sequoia-hope/rgb_led_earrings/earring.kicad_pcb

## KiCad design earring.kicad_pcb (2025-07-21)

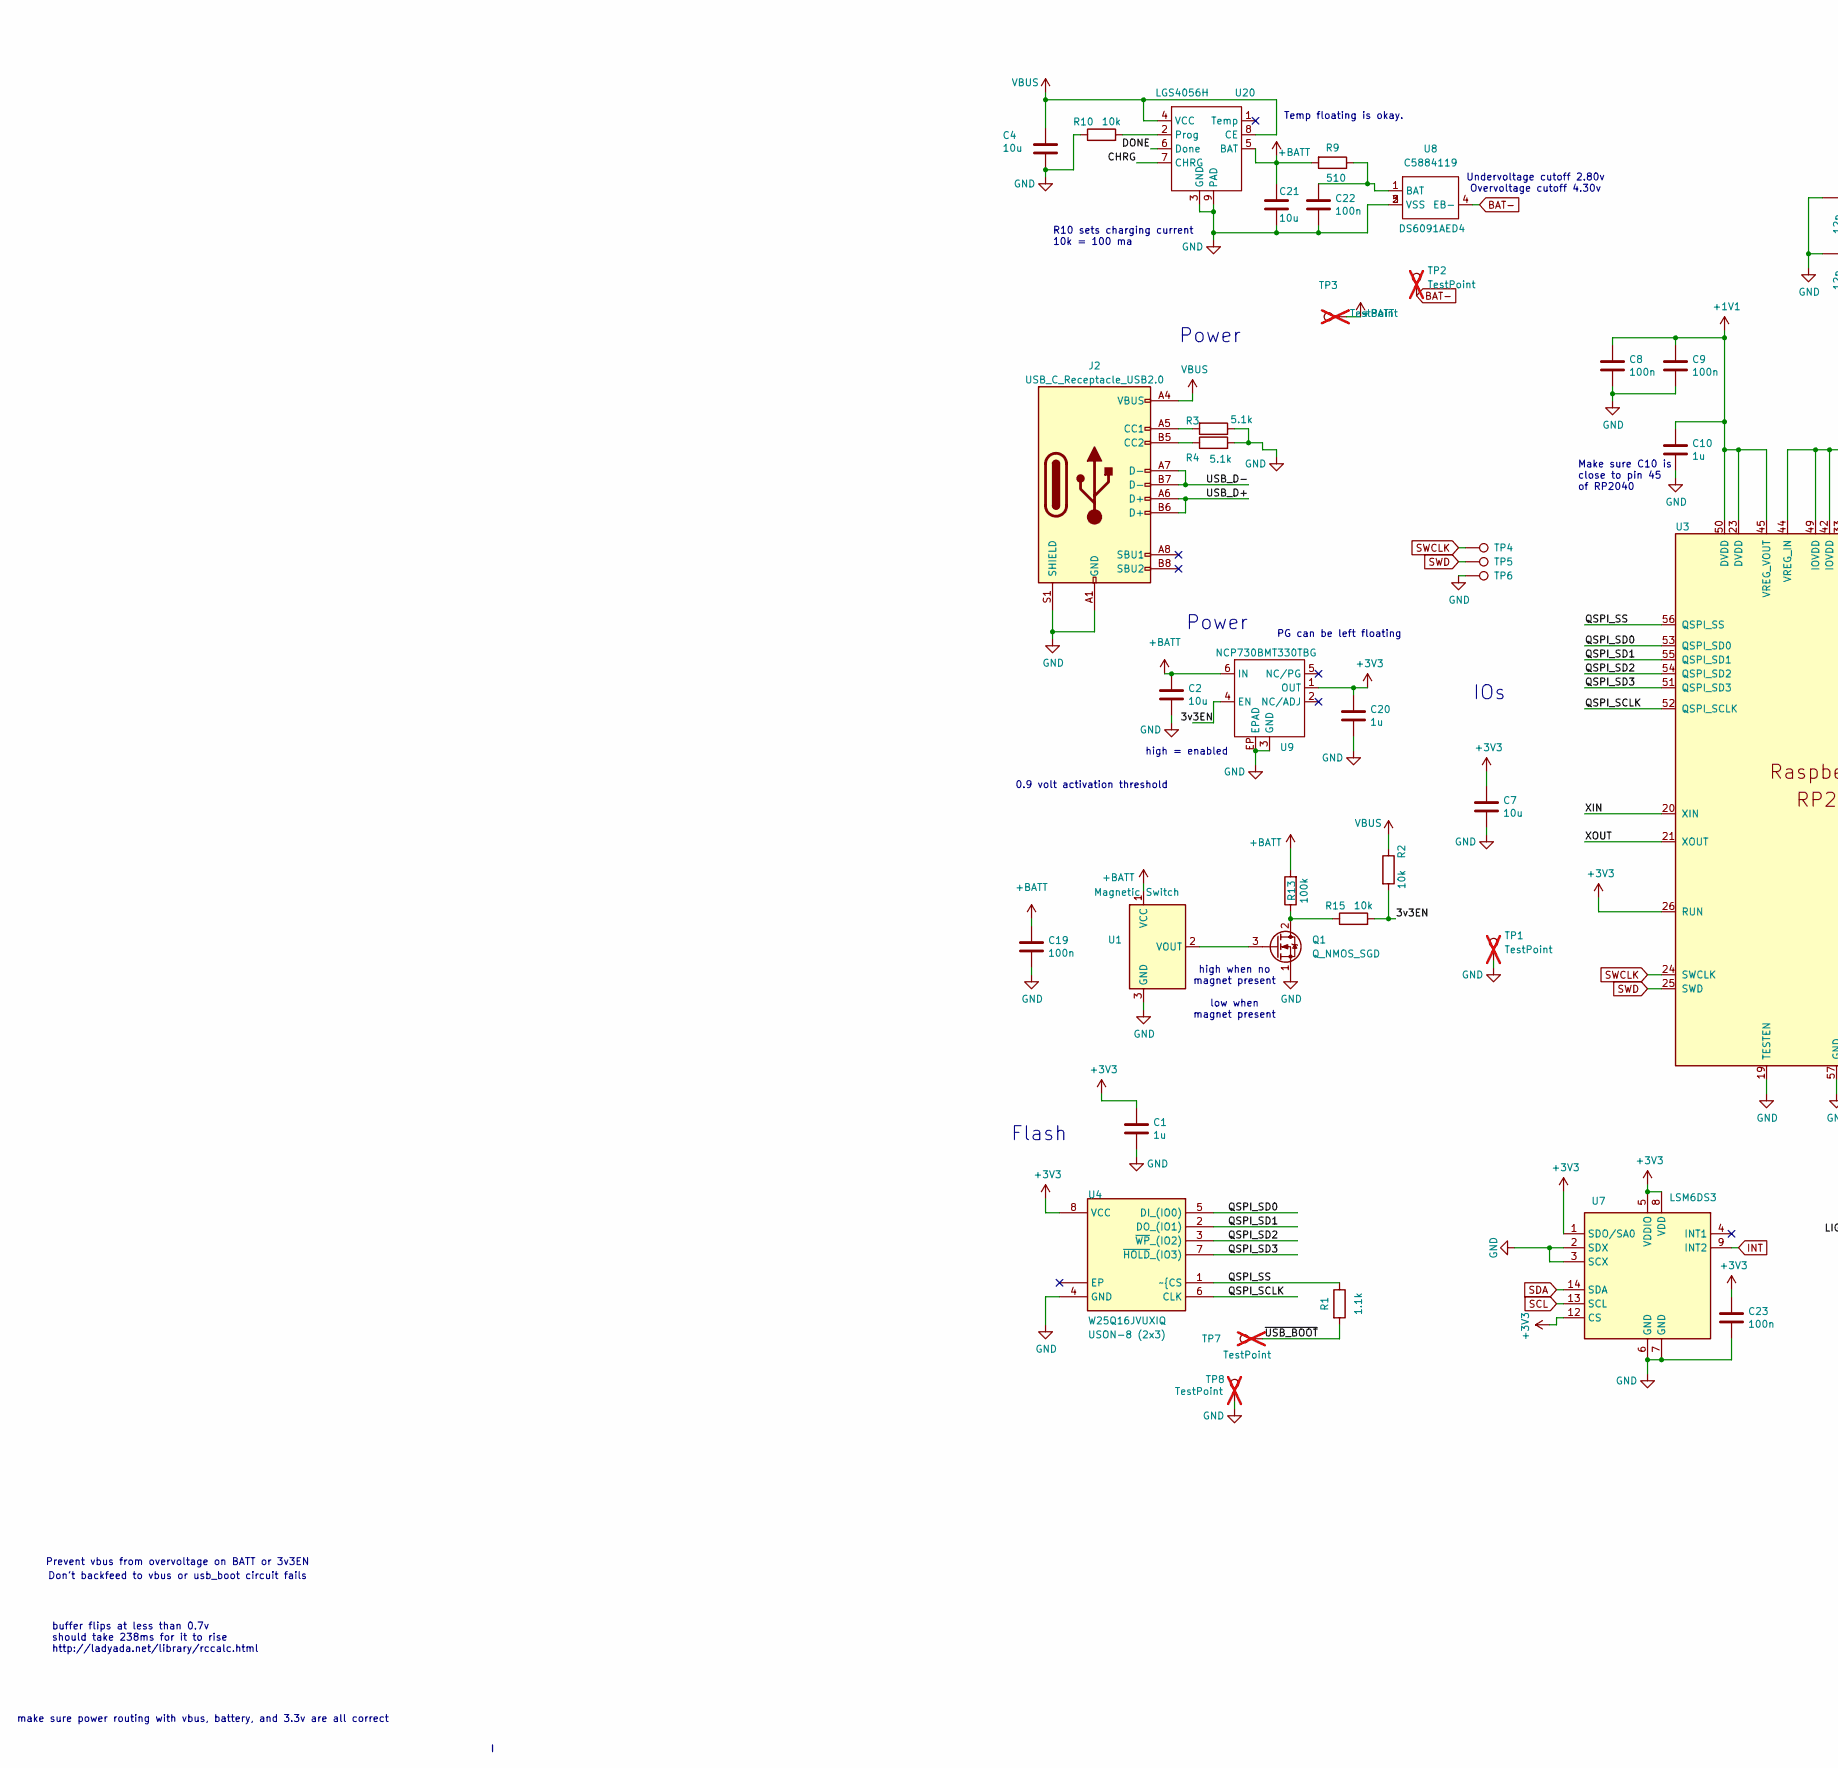
[picture p1: schematic earring.kicad_sch, RP2040 Earring, part in row 1, column 1]

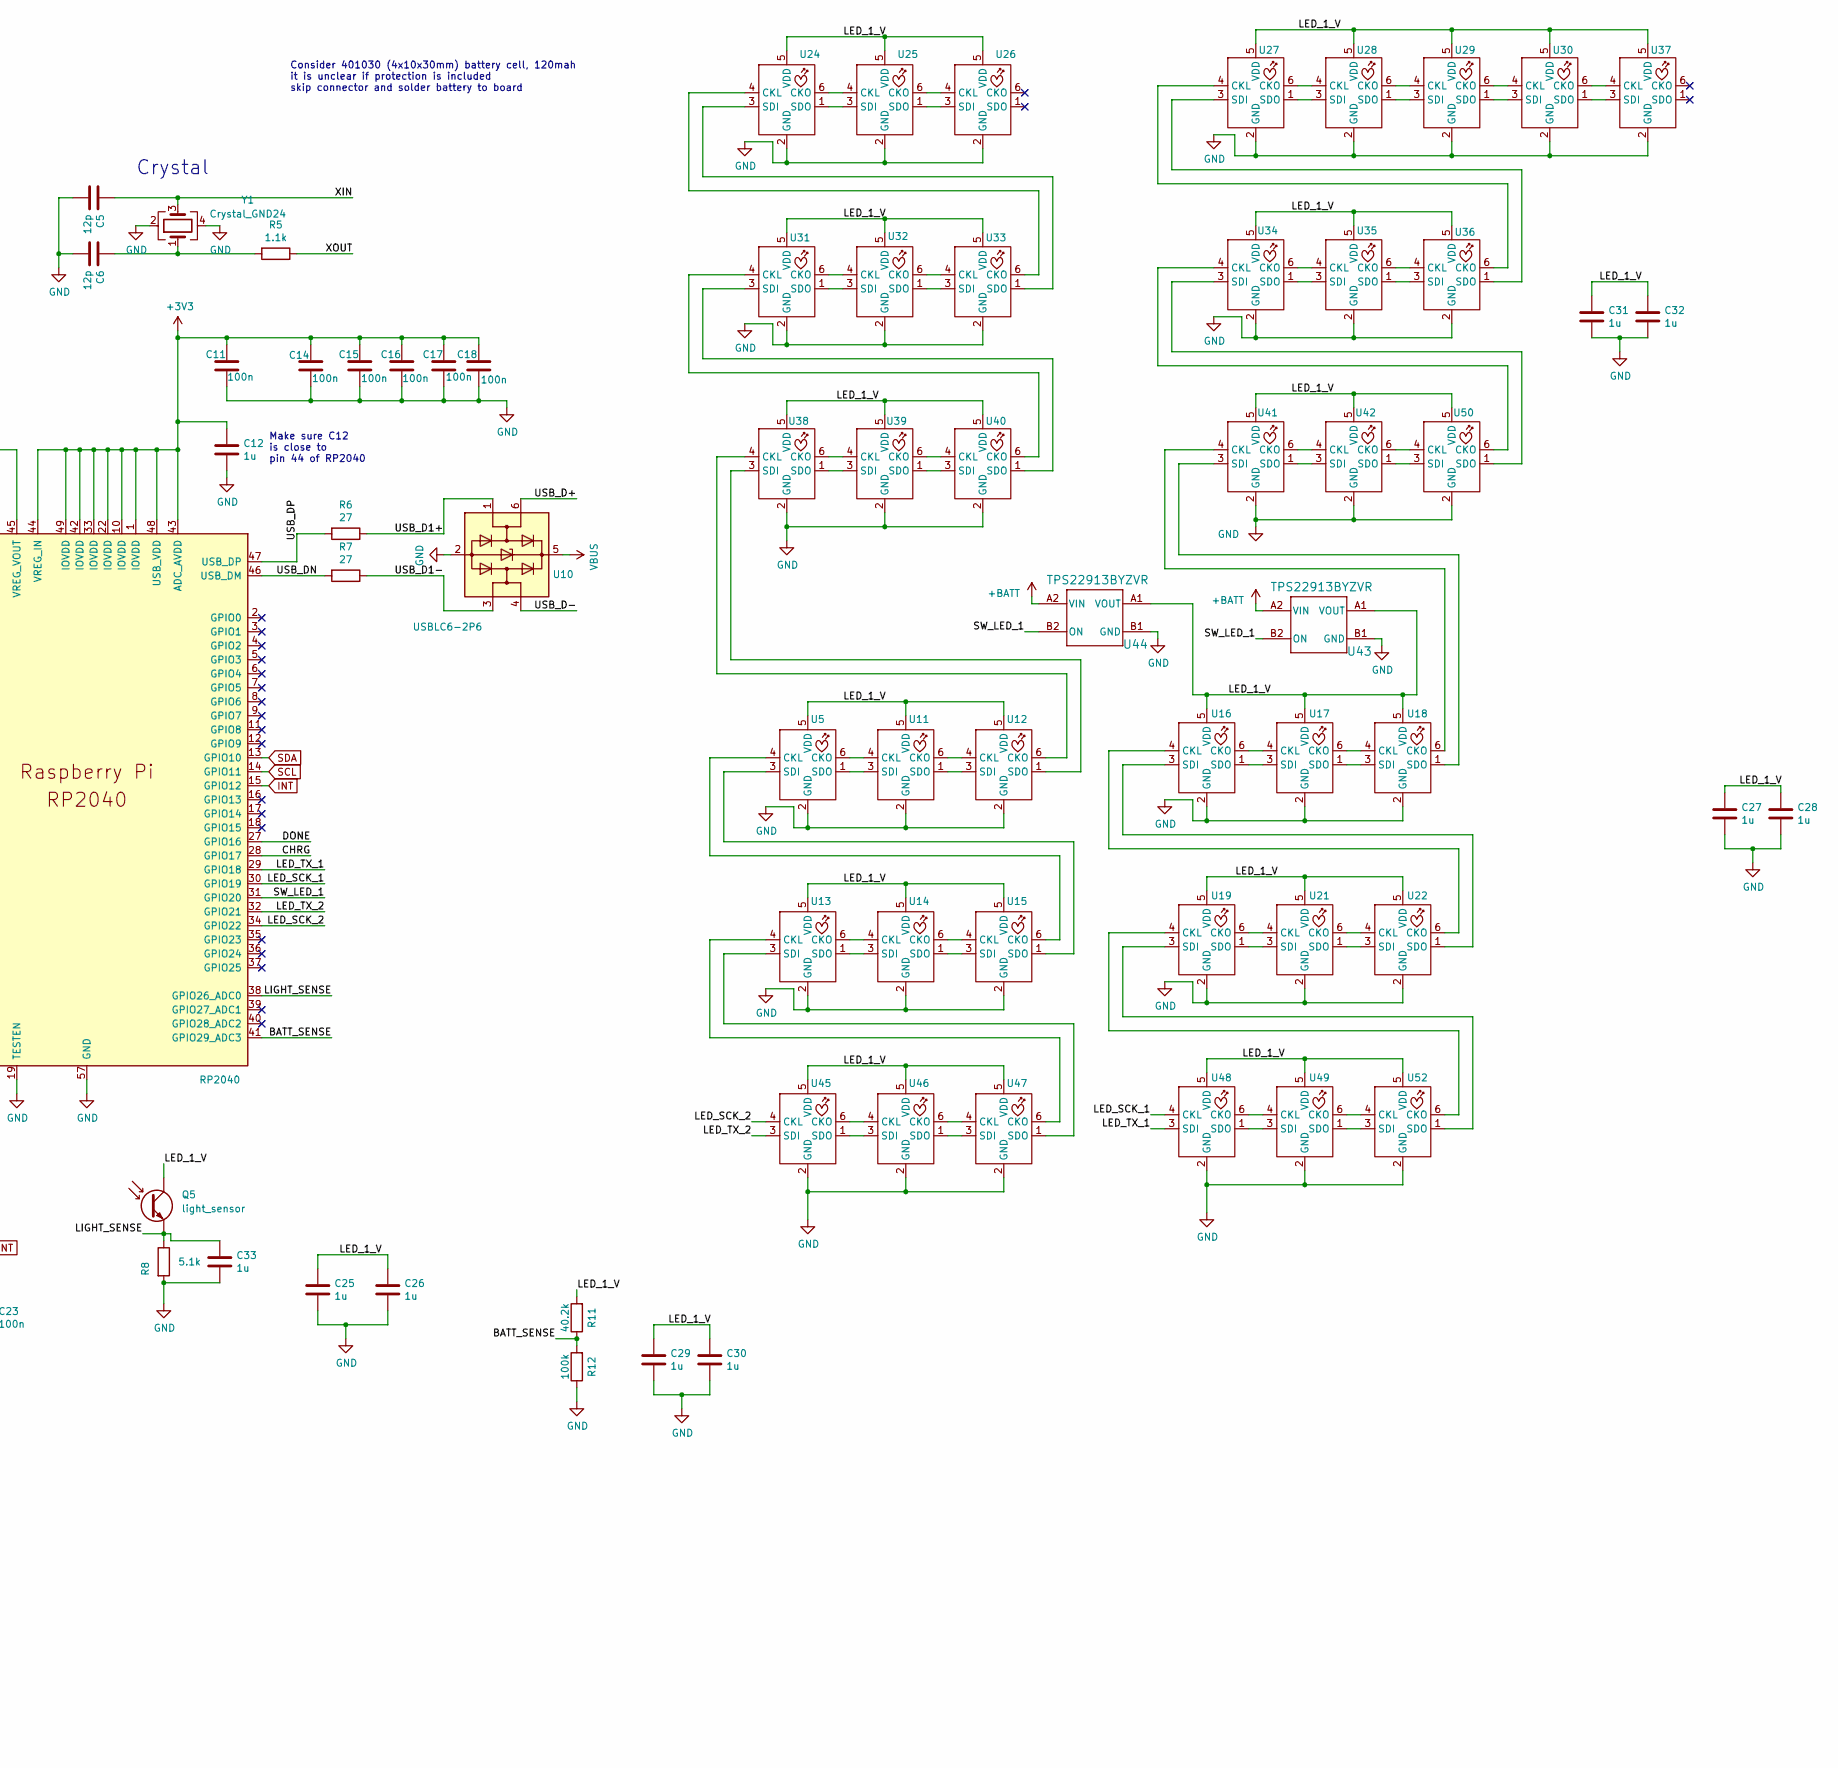
[picture p2: schematic earring.kicad_sch, RP2040 Earring, part in row 1, column 2]

Parts:
C1, C10, C12, C20, C25, C26, C27, C28, C29, C30, C31, C32, C33: 1u; C_0402_1005Metric; LCSC C29266
C2, C4, C7, C21: 10u; C_0402_1005Metric; LCSC C315248
C5, C6: 12p; C_0402_1005Metric; LCSC C1547
C8, C9, C11, C14, C15, C16, C17, C18, C19, C22, C23: 100n; C_0402_1005Metric; LCSC C60474
J2: USB_C_Receptacle_USB2.0; USB-C-TH_GT-USB-7055; LCSC C2686963
Q1: Q_NMOS_SGD; DFN1006-3L_L1.0-W0.6-BL; LCSC C504101
Q5: light_sensor; LED_0603_1608Metric; LCSC C146233
R1, R5: 1.1k; R_0402_1005Metric; LCSC C325543
R2, R10, R15: 10k; R_0402_1005Metric; LCSC C60490
R3, R4, R8: 5.1k; R_0402_1005Metric; LCSC C25905
R6, R7: 27; R_0402_1005Metric; LCSC C138021
R9: 510; R_0402_1005Metric; LCSC C137860
R11: 40.2k; R_0402_1005Metric; LCSC C25893
R12, R13: 100k; R_0402_1005Metric; LCSC C60491
TP1, TP7, TP8: TestPoint; TestPoint_Pad_D1.0mm; LCSC C238130; not fitted
TP2, TP3: TestPoint; TestPoint_Pad_2.0x2.0mm; LCSC C238130; not fitted
TP4, TP5, TP6: TestPoint; TestPoint_Pad_1.0x1.0mm
U1: Magnetic Switch; DFN1608-3_L1.5-W0.8-P0.42-BL-EP; LCSC C879626
U3: RP2040; RP2040-QFN-56; LCSC C2040
U4: W25Q16JVUXIQ; IC_W25Q16JVUXIQ_TR; MPN W25Q16JVUXIQ; LCSC C2843335
U5, U11, U12, U13, U14, U15, U16, U17, U18, U19, U21, U22, U24, U25, U26, U27, U28, U29, U30, U31, U32, U33, U34, U35, U36, U37, U38, U39, U40, U41, U42, U45, U46, U47, U48, U49, U50, U52: LED-SK9822-EC20
U7: LSM6DS3; LGA-14_3x2.5mm_P0.5mm_LayoutBorder3x4y; LCSC C2829074
U8: DS6091AED4; DFN1x1; LCSC C5884119
U9: NCP730BMT330TBG; WDFN-6-2x2; LCSC C892821
U10: USBLC6-2P6; SOT-666; LCSC C2827693
U20: LGS4056H; DFN-8-1EP_2x2mm_P0.5mm_EP0.9x1.5mm; LCSC C5124109
U43, U44: TPS22913BYZVR; YZV0004ADAD; LCSC C544698
Y1: Crystal_GND24; Crystal_SMD_2520-4Pin_2.5x2.0mm; LCSC C284155

Connections:
+1V1: C8.1, C9.1, C10.1, U3.23 (DVDD), U3.45 (VREG_VOUT), U3.50 (DVDD)
+3V3: C1.1, C7.1, C11.1, C12.1, C14.1, C15.1, C16.1, C17.1, C18.1, C20.1, C23.1, U3.1 (IOVDD), U3.10 (IOVDD), U3.22 (IOVDD), U3.26 (RUN), U3.33 (IOVDD), U3.42 (IOVDD), U3.43 (ADC_AVDD), U3.44 (VREG_IN), U3.48 (USB_VDD), U3.49 (IOVDD), U4.8 (VCC), U7.1 (SDO/SA0), U7.5 (VDDIO), U7.8 (VDD), U7.12 (CS), U9.1 (OUT)
+BATT: C2.1, C19.1, C21.1, R9.2, R13.2, TP3.1, U1.1 (VCC), U9.6 (IN), U20.5 (BAT), U43.A2 (VIN), U44.A2 (VIN)
/3v3EN: R2.2, R15.2, U9.4 (EN)
/BATT_SENSE: R11.1, R12.2, U3.41 (GPIO29_ADC3)
/CHRG: U3.28 (GPIO17), U20.7 (CHRG)
/DONE: U3.27 (GPIO16), U20.6 (Done)
/LED_1_V: C25.1, C26.1, C27.1, C28.1, C29.1, C30.1, C31.1, C32.1, Q5.1, R11.2, U5.5 (VDD), U11.5 (VDD), U12.5 (VDD), U13.5 (VDD), U14.5 (VDD), U15.5 (VDD), U16.5 (VDD), U17.5 (VDD), U18.5 (VDD), U19.5 (VDD), U21.5 (VDD), U22.5 (VDD), U24.5 (VDD), U25.5 (VDD), U26.5 (VDD), U27.5 (VDD), U28.5 (VDD), U29.5 (VDD), U30.5 (VDD), U31.5 (VDD), U32.5 (VDD), U33.5 (VDD), U34.5 (VDD), U35.5 (VDD), U36.5 (VDD), U37.5 (VDD), U38.5 (VDD), U39.5 (VDD), U40.5 (VDD), U41.5 (VDD), U42.5 (VDD), U43.A1 (VOUT), U44.A1 (VOUT), U45.5 (VDD), U46.5 (VDD), U47.5 (VDD), U48.5 (VDD), U49.5 (VDD), U50.5 (VDD), U52.5 (VDD)
/LED_SCK_1: U3.30 (GPIO19), U48.4 (CKL)
/LED_SCK_2: U3.34 (GPIO22), U45.4 (CKL)
/LED_TX_1: U3.29 (GPIO18), U48.3 (SDI)
/LED_TX_2: U3.32 (GPIO21), U45.3 (SDI)
/LIGHT_SENSE: C33.1, Q5.2, R8.1, U3.38 (GPIO26_ADC0)
/QSPI_SCLK: U3.52 (QSPI_SCLK), U4.6 (CLK)
/QSPI_SD0: U3.53 (QSPI_SD0), U4.5 (DI_(IO0))
/QSPI_SD1: U3.55 (QSPI_SD1), U4.2 (DO_(IO1))
/QSPI_SD2: U3.54 (QSPI_SD2), U4.3 (~WP_(IO2))
/QSPI_SD3: U3.51 (QSPI_SD3), U4.7 (~HOLD_(IO3))
/QSPI_SS: R1.1, U3.56 (QSPI_SS), U4.1 (~{CS)
/SW_LED_1: U3.31 (GPIO20), U43.B2 (ON), U44.B2 (ON)
/USB_D1+: R6.1, U10.1 (I/O1)
/USB_D1-: R7.1, U10.3 (I/O2)
/USB_D+: J2.A6 (D+), J2.B6 (D+), U10.6 (I/O1)
/USB_D-: J2.A7 (D-), J2.B7 (D-), U10.4 (I/O2)
/USB_DN: R7.2, U3.46 (USB_DM)
/USB_DP: R6.2, U3.47 (USB_DP)
/XIN: C5.1, U3.20 (XIN), Y1.3
/XOUT: R5.1, U3.21 (XOUT)
/~USB_BOOT: R1.2, TP7.1
BAT-: TP2.1, U8.4 (EB-)
GND: C1.2, C2.2, C4.2, C5.2, C6.2, C7.2, C8.2, C9.2, C10.2, C11.2, C12.2, C14.2, C15.2, C16.2, C17.2, C18.2, C19.2, C20.2, C21.2, C22.2, C23.2, C25.2, C26.2, C27.2, C28.2, C29.2, C30.2, C31.2, C32.2, C33.2, J2.A1 (GND), J2.A12 (GND), J2.B1 (GND), J2.B12 (GND), J2.S1 (SHIELD), Q1.1 (S), R3.1, R4.2, R8.2, R10.1, R12.1, TP1.1, TP6.1, TP8.1, U1.3 (GND), U3.19 (TESTEN), U3.57 (GND), U4.4 (GND), U5.2 (GND), U7.2 (SDX), U7.3 (SCX), U7.6 (GND), U7.7 (GND), U8.2 (VSS), U8.3 (VSS), U8.5 (VSS), U9.3 (GND), U9.EP (EPAD), U10.2 (GND), U11.2 (GND), U12.2 (GND), U13.2 (GND), U14.2 (GND), U15.2 (GND), U16.2 (GND), U17.2 (GND), U18.2 (GND), U19.2 (GND), U20.3 (GND), U20.9 (PAD), U21.2 (GND), U22.2 (GND), U24.2 (GND), U25.2 (GND), U26.2 (GND), U27.2 (GND), U28.2 (GND), U29.2 (GND), U30.2 (GND), U31.2 (GND), U32.2 (GND), U33.2 (GND), U34.2 (GND), U35.2 (GND), U36.2 (GND), U37.2 (GND), U38.2 (GND), U39.2 (GND), U40.2 (GND), U41.2 (GND), U42.2 (GND), U43.B1 (GND), U44.B1 (GND), U45.2 (GND), U46.2 (GND), U47.2 (GND), U48.2 (GND), U49.2 (GND), U50.2 (GND), U52.2 (GND), Y1.2, Y1.4
INT: U3.15 (GPIO12), U7.9 (INT2)
unnamed: C6.1, R5.2, Y1.1
unnamed: J2.A5 (CC1), R3.2
unnamed: J2.B5 (CC2), R4.1
unnamed: Q1.2 (D), R13.1, R15.1
unnamed: Q1.3 (G), U1.2 (VOUT)
unnamed: C22.1, R9.1, U8.1 (BAT)
unnamed: U5.6 (CKO), U11.4 (CKL)
unnamed: U11.6 (CKO), U12.4 (CKL)
unnamed: U5.1 (SDO), U11.3 (SDI)
unnamed: U11.1 (SDO), U12.3 (SDI)
unnamed: U12.6 (CKO), U38.4 (CKL)
unnamed: U12.1 (SDO), U38.3 (SDI)
unnamed: U13.4 (CKL), U47.6 (CKO)
unnamed: U13.6 (CKO), U14.4 (CKL)
unnamed: U13.3 (SDI), U47.1 (SDO)
unnamed: U13.1 (SDO), U14.3 (SDI)
unnamed: U14.6 (CKO), U15.4 (CKL)
unnamed: U14.1 (SDO), U15.3 (SDI)
unnamed: U5.4 (CKL), U15.6 (CKO)
unnamed: U5.3 (SDI), U15.1 (SDO)
unnamed: U16.4 (CKL), U22.6 (CKO)
unnamed: U16.6 (CKO), U17.4 (CKL)
unnamed: U16.3 (SDI), U22.1 (SDO)
unnamed: U16.1 (SDO), U17.3 (SDI)
unnamed: U17.6 (CKO), U18.4 (CKL)
unnamed: U17.1 (SDO), U18.3 (SDI)
unnamed: U18.6 (CKO), U41.4 (CKL)
unnamed: U18.1 (SDO), U41.3 (SDI)
unnamed: U19.4 (CKL), U52.6 (CKO)
unnamed: U19.6 (CKO), U21.4 (CKL)
unnamed: U19.3 (SDI), U52.1 (SDO)
unnamed: U19.1 (SDO), U21.3 (SDI)
unnamed: R10.2, U20.2 (Prog)
unnamed: U21.6 (CKO), U22.4 (CKL)
unnamed: U21.1 (SDO), U22.3 (SDI)
unnamed: U24.4 (CKL), U33.6 (CKO)
unnamed: U24.6 (CKO), U25.4 (CKL)
unnamed: U24.3 (SDI), U33.1 (SDO)
unnamed: U24.1 (SDO), U25.3 (SDI)
unnamed: U25.6 (CKO), U26.4 (CKL)
unnamed: U25.1 (SDO), U26.3 (SDI)
unnamed: U27.4 (CKL), U36.6 (CKO)
unnamed: U27.6 (CKO), U28.4 (CKL)
unnamed: U27.3 (SDI), U36.1 (SDO)
unnamed: U27.1 (SDO), U28.3 (SDI)
unnamed: U28.6 (CKO), U29.4 (CKL)
unnamed: U28.1 (SDO), U29.3 (SDI)
unnamed: U29.6 (CKO), U30.4 (CKL)
unnamed: U29.1 (SDO), U30.3 (SDI)
unnamed: U30.6 (CKO), U37.4 (CKL)
unnamed: U30.1 (SDO), U37.3 (SDI)
unnamed: U31.4 (CKL), U40.6 (CKO)
unnamed: U31.6 (CKO), U32.4 (CKL)
unnamed: U31.3 (SDI), U40.1 (SDO)
unnamed: U31.1 (SDO), U32.3 (SDI)
unnamed: U32.6 (CKO), U33.4 (CKL)
unnamed: U32.1 (SDO), U33.3 (SDI)
unnamed: U34.4 (CKL), U50.6 (CKO)
unnamed: U34.6 (CKO), U35.4 (CKL)
unnamed: U34.3 (SDI), U50.1 (SDO)
unnamed: U34.1 (SDO), U35.3 (SDI)
unnamed: U35.6 (CKO), U36.4 (CKL)
unnamed: U35.1 (SDO), U36.3 (SDI)
unnamed: U38.6 (CKO), U39.4 (CKL)
unnamed: U38.1 (SDO), U39.3 (SDI)
unnamed: U39.6 (CKO), U40.4 (CKL)
unnamed: U39.1 (SDO), U40.3 (SDI)
unnamed: U41.6 (CKO), U42.4 (CKL)
unnamed: U41.1 (SDO), U42.3 (SDI)
unnamed: U42.6 (CKO), U50.4 (CKL)
unnamed: U42.1 (SDO), U50.3 (SDI)
unnamed: U45.6 (CKO), U46.4 (CKL)
unnamed: U45.1 (SDO), U46.3 (SDI)
unnamed: U46.6 (CKO), U47.4 (CKL)
unnamed: U46.1 (SDO), U47.3 (SDI)
unnamed: U48.6 (CKO), U49.4 (CKL)
unnamed: U48.1 (SDO), U49.3 (SDI)
unnamed: U49.6 (CKO), U52.4 (CKL)
unnamed: U49.1 (SDO), U52.3 (SDI)
SCL: U3.14 (GPIO11), U7.13 (SCL)
SDA: U3.13 (GPIO10), U7.14 (SDA)
SWCLK: TP4.1, U3.24 (SWCLK)
SWD: TP5.1, U3.25 (SWD)
VBUS: C4.1, J2.A4 (VBUS), J2.A9 (VBUS), J2.B4 (VBUS), J2.B9 (VBUS), R2.1, U10.5 (VBUS), U20.4 (VCC), U20.8 (CE)

Notes on the sheet:
Make sure C10 is close to pin 45 of RP2040
Prevent vbus from overvoltage on BATT or 3v3EN
Consider 401030 (4x10x30mm) battery cell, 120mah it is unclear if protection is included skip connector and solder battery to board
Power
Crystal
R10 sets charging current 10k = 100 ma
IOs
Undervoltage cutoff 2.80v Overvoltage cutoff 4.30v
high when no magnet present low when magnet present
Don't backfeed to vbus or usb_boot circuit fails
PG can be left floating
Make sure C12 is close to pin 44 of RP2040
0.9 volt activation threshold
make sure power routing with vbus, battery, and 3.3v are all correct
high = enabled
buffer flips at less than 0.7v should take 238ms for it to rise http://ladyada.net/library/rccalc.html
Temp floating is okay.
Flash

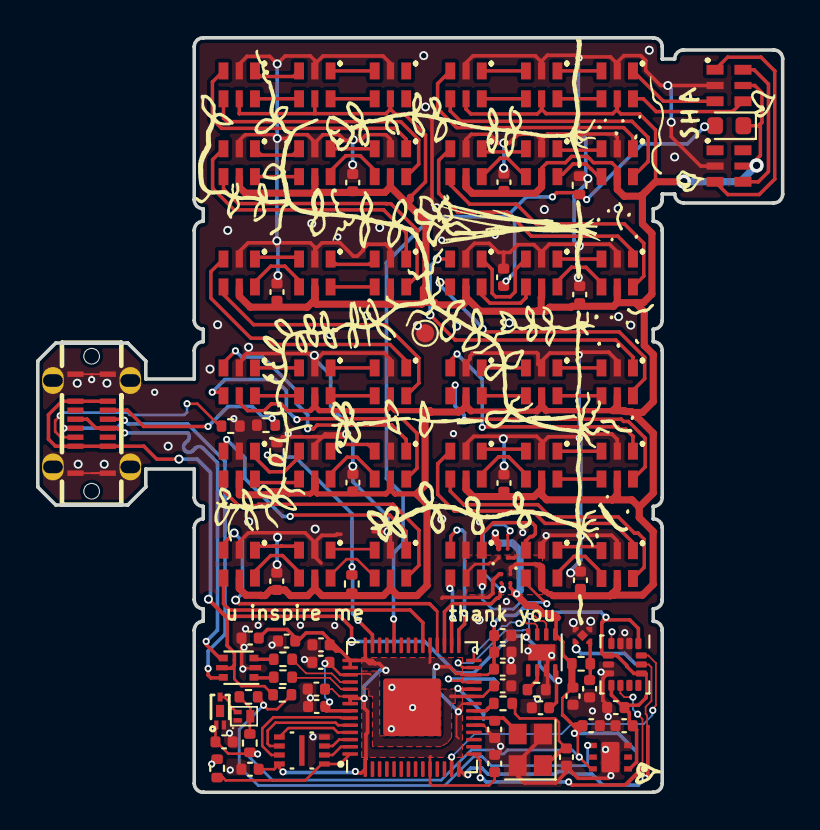
[picture p3: board earring.kicad_pcb from above]

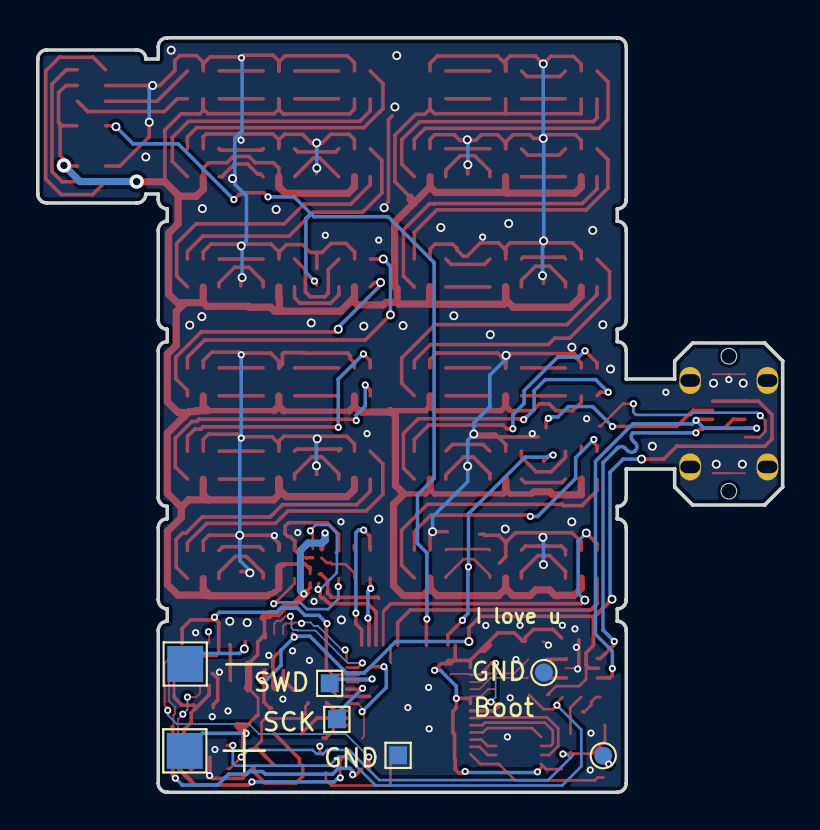
[picture p4: board earring.kicad_pcb from below]

Board: 2 copper layers, 41.4 x 41.9 mm, 104 parts (7 on the bottom side), 116 nets.
