sequoia-hope/rgb_led_earrings/(commit log)

2025-03-09 rework power control to simplify and remove VBAT from MCU pins
    [earring.kicad_pcb, earring.kicad_sch]
2025-05-18 check in complex startup circuit before simplification
    [earring.kicad_pcb, earring.kicad_sch]
2025-05-18 simplify power and boot circuit
    [earring.kicad_pcb, earring.kicad_sch]
2025-06-13 pcb files seem possibly ready to order
    [earring.kicad_pcb, earring.kicad_sch]
2025-06-20 about to rewire
    [earring.kicad_sch]
2025-06-25 Fixed power circuit and ordered June 2025
    [earring.kicad_pcb, earring.kicad_sch]
2025-07-02 Had to cancel order, fixing DRC issues in progress.
    [earring.kicad_pcb]
2025-07-15 more clean up. looking pretty good
    [earring.kicad_pcb, earring.kicad_sch]
2025-07-21 updated with better clearance, ordered this rev after canceling the last order
    [earring.kicad_pcb, earring.kicad_sch]
