sequoia-hope/rgb_led_earrings/(notices)

Notices in the files:
earring.kicad_sch:
LICENSE: CERN-OHL-P
